lakshya0310/Audio-Amplifier/Project1_Report.pdf

EW-2, EC2.202, Spring 2026 | Audio Amplifier - Project 1

Four-Stage Audio Amplifier: Design, Analysis, and Hardware Verification

Electronics Workshop-II | | EC2.202 | | Spring 2026 | | Project 1

Sai Ritvik Uppuganti

2025122012

Lakshya Jindal

2023112017

March 2026

Abstract

This paper presents the complete theoretical design, DC/AC small-signal analysis, LTspice simulation, and hardware verification of a four-stage audio amplifier. The circuit amplifies microphone-level signals (10-20 mV peak-to-peak) to drive a 10 Ω loudspeaker across the full audible band (20 Hz-20 kHz). The four stages are: (1) a differential long-tailed-pair (LTP) pre-amplifier (BC547B), (2) a common-emitter (CE) voltage gain stage (BC547B),
(3) an active band-pass filter implemented as a cascade of an inverting first-order HPF and a unity-gain Sallen-Key second-order LPF (UA741), and (4) a Class AB complementary push-pull power amplifier (TIP31A/TIP32A). The combined voltage gain from Stages 1 and 2, accounting for inter-stage loading, is ≈ 506, satisfying the ≥500 specification. Stages 3 and 4 each operate at unity voltage gain (≈ 1.0). Filter −3 dB cutoffs: HPF at 17.5 Hz, LPF at 38.9 kHz (UA741-limited to ≈ 24 kHz in simulation), both outside the audio band. Hardware measurements using a Keysight EDUX1052G oscilloscope confirm ≈8.8 V pk-pk output at 10 kHz with a 21.7 mV pk-pk input, corresponding to a voltage gain of ≈405 at the hardware operating point.
I. INTRODUCTION
This project documents a four-stage discrete audio amplifier built and tested as part of EW-2, EC2.202. The target is a voltage gain ≥500 from the first two stages, with the filter and power stages operating at unity gain. Sections IV-VII cover each stage in detail; Section VIII presents hardware Bode and oscilloscope measurements.

II. DESIGN SPECIFICATIONS

Table 1 lists the system-level design targets.

Table 1: System-level specifications

Parameter | Specification
Input level | 10-20 mV pk-pk
Bandwidth | 20 Hz - 20 kHz
Voltage gain | G1+2 ≥ 500
Output power | ≥ 1.5W
Load | 10 Ω
Supply | ±5 V (Stages 1,2,4);
±12 V (Stage 3)
Clipping | None for 10 mV in-
| put
Filter f−3dB | 17 Hz | (HPF),
23 kHz (LPF)

III. SYSTEM OVERVIEW
A. Signal-Flow Architecture

Mic
Interface

Stage 1 Diff Pre-amp
Stage 2 CE Gain

Stage 3 SK BPF

Stage 4 Class AB

10 Ω
Load
Acoust. | ∼ 10 mV | |Av1|≈20.5 | |Av2|≈24.7 | |H|≈1 | P ≥1.5W

Figure 1: Signal-flow block diagram (five stages + load)

B. Gain Budget
The gain budget is designed so that the complete voltage amplification is provided exclusively by Stages 1 and 2, while Stages 3 and 4 contribute unity voltage gain. Table 2 summarises the budget.

Table 2: Voltage gain budget

Stage | Function | |Av|
Stage 1 | Diff. pre-amp (LTP) | 20.5
Stage 2 | CE gain stage | 24.7
Stage 3 | Active BPF | ≈ 1.00
Stage 4 | Class AB power amp | ≈ 1.00
Total | (Stages 1+2) | ≈ 506

The loaded gain from Stages 1+2:

G1,2 = |Av1,exact| × |Av2| = 20.5 × 24.7 ≈ | 506 | ≥ 500
(1)

IV. MICROPHONE INTERFACE CIRCUIT
A. Circuit Description
An electret condenser microphone is biased from +5 V and AC-coupled to the Stage 1 input via three components (Table 3).

Table 3: Microphone interface components

Symbol | Value | Function
Rbias | 2.2 kΩ | Mic drain bias (VCC to mic)
Rin | 50 kΩ | DC return / input pull-down
Cmic | 10 µF | AC coupling

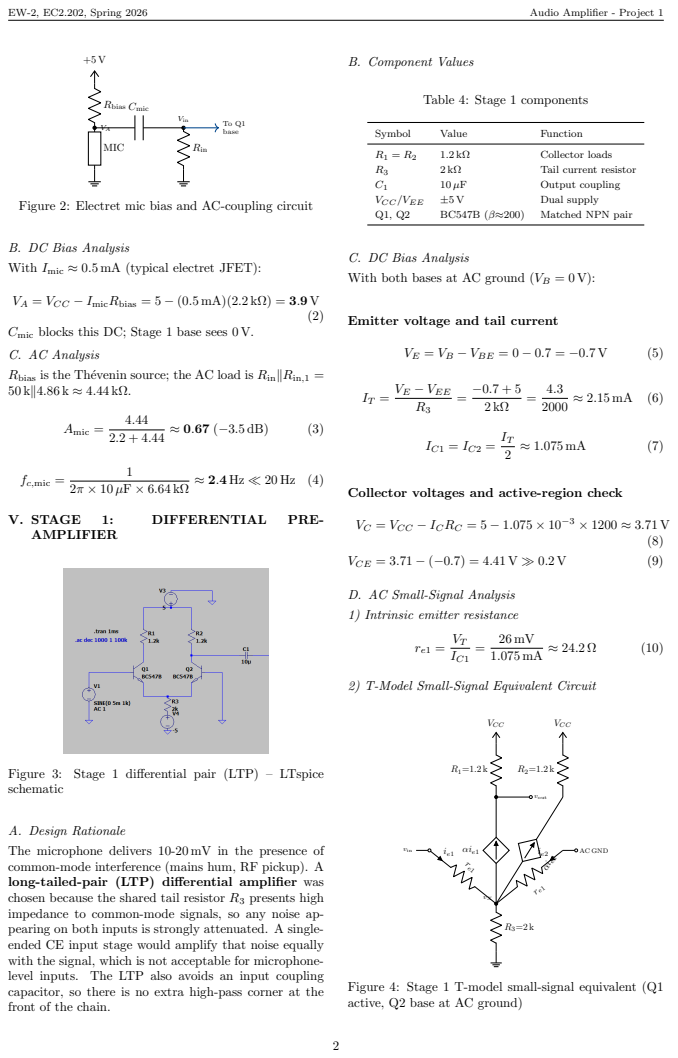
[picture p1: page 2]

Figure 2: Electret mic bias and AC-coupling circuit

B. DC Bias Analysis
With Imic ≈ 0.5 mA (typical electret JFET):

C. DC Bias Analysis
With both bases at AC ground (VB = 0 V):

VA = VCC − ImicRbias = 5 − (0.5 mA)(2.2 kΩ) = 3.9 V

Emitter voltage and tail current

Cmic blocks this DC; Stage 1 base sees 0 V.

C. AC Analysis
Rbias is the Th´evenin source; the AC load is Rin∥Rin,1 =

Collector voltages and active-region check

VC = VCC − IC RC = 5 − 1.075 × 10⁻³ × 1200 ≈ 3.71 V

D. AC Small-Signal Analysis
1) Intrinsic emitter resistance

2) T-Model Small-Signal Equivalent Circuit

Figure 3: Stage 1 differential pair (LTP) – LTspice
schematic

A. Design Rationale
The microphone delivers 10-20 mV in the presence of
common-mode interference (mains hum, RF pickup). A
long-tailed-pair (LTP) differential amplifier was
chosen because the shared tail resistor R3 presents high
impedance to common-mode signals, so any noise ap-
pearing on both inputs is strongly attenuated. A single-
ended CE input stage would amplify that noise equally
with the signal, which is not acceptable for microphone-
level inputs. The LTP also avoids an input coupling
capacitor, so there is no extra high-pass corner at the
front of the chain.

Figure 4: Stage 1 T-model small-signal equivalent (Q1
active, Q2 base at AC ground)

3) Differential gain (KCL derivation)
Let vX be the AC voltage at the shared emitter node. Applying KCL (T-model, β ≫ 1):

ie1 + ie2 =

vX
R3

vin − vX

re1

+

−vX

re1

=

vX
R3

(11)

Solving:

vX = vin ·

R3
2R3 + re1

R3≫re1 −−−−−→

vin
2

(12)

The collector current of Q1 is:

ic1 =

vin − vX

re1

=

vin

re1

·

R3 + re1
2R3 + re1

(13)

The output node connects through C1 into Stage 2 whose input resistance Rin,2 = RB1 ∥ RB2 ∥ β(re2+RE2) loads the Stage 1 collector. With Stage 2 parameters (RB1 = 180 kΩ, RB2 = 20 kΩ, re2 = 26 Ω, RE2 = 140 Ω):

RB1 ∥ RB2 = 18 kΩ
β(re2 + RE2) = 200 × 166 = 33.2 kΩ
Rin,2 = 18 k ∥ 33.2 k ≈ 11.7 kΩ (14)

The effective Stage 1 load is:

RC,eff = R1 ∥ Rin,2 = 1200 ∥ 11700 ≈ 1078 Ω (15)

The ideal single-ended differential gain (T-model, β → ∞):

Av1,ideal = −

RC
2 re1

= −

1200
2 × 24.2

≈ −24.8 (16)

Including finite-β base-current loading at the tail node (Sedra-Smith, Microelectronic Circuits, 7th ed., §8.3):

A

exact
v1 = −

RC

2

re +

R3

2(β+1)

= −

1200
2(24.2 + 4.98) ≈ | −20.5 | (β = 200)

(17)

LTspice simulation confirms |Av1| ≈ 21-22. The exact value −20.5 is used as the design gain throughout; −24.8 is the β → ∞ upper bound.
4) Common-mode gain and CMRR
For a common-mode input vcm both emitters rise together; the tail resistor R3 presents a negative-feedback path:

Ac = −

RC
2R3 + re1

= −

1200
4000 + 24.2

≈ −0.300 (18)

CMRR = 20 log10
|Av1,ideal|
|Ac|

= 20 log10
24.8

0.300

≈ 38.3 dB | (19)
E. Input and Output Impedance

Rin,1 =

βre1
2
∥ source ≈ 2.4 kΩ | (20)
Rout,1 = R1 = 1.2 kΩ | (21)
VI. STAGE 2: | COMMON-EMITTER GAIN
STAGE

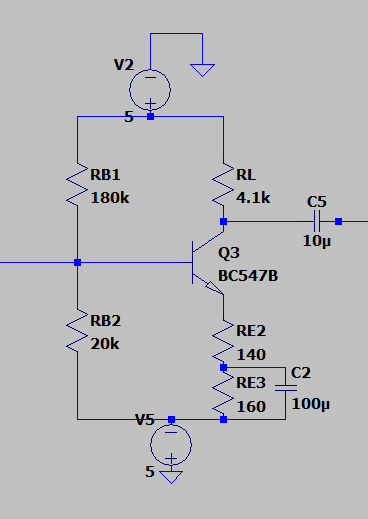
[picture p2: figure]

Figure 5: Stage 2 common-emitter gain stage – LTspice schematic

A. Design Rationale
Following Stage 1, the signal is around 140-280 mV pk-pk and needs further voltage amplification. The common-emitter (CE) configuration gives the highest voltage gain of any single-transistor stage. A commonbase stage was not used here because its low input impedance would load Stage 1’s 1.2 kΩ collector and drop Av1 below target; an emitter follower does not provide voltage gain at all. The partially bypassed emitter (RE1 unbypassed, RE2 bypassed) is a practical compromise: RE1 provides enough local negative feedback to keep the gain stable across transistor samples, while RE2’s bypass restores adequate voltage gain. Voltagedivider bias from the ±5 V rails sets a stable Q-point independent of transistor β.
B. Component Values

Table 5: Stage 2 components

Symbol | Value | Function
RB1 | 180 kΩ | Bias divider (top)
RB2 | 20 kΩ | Bias divider (bottom)
RL | 4.1 kΩ | Collector load
RE1 | 140 Ω | Unbypassed emitter R
RE2 | 160 Ω | Bypassed emitter R
Cbyp | 100 µF | Emitter bypass cap
C5 | 10 µF | Output coupling cap
Q3 | BC547B (β≈200) | CE transistor
C. DC Bias Analysis
Thevenin equivalent base voltage With ±5 V rails the divider sees a 10 V span:

VB = −5+10·

| RB2
| RB1 + RB2

= −5+10·

20
= −5+1 = −4 V
(22)

VE = VB − VBE = −4 − 0.7 = −4.7 V | (23)

IC =

VE − VEE

RE1 + RE2

=

−4.7 + 5
300

=

0.3
300

= 1.0 mA (24)

VC = VCC − IC RL = 5 − 1.0 × 10⁻³ × 4100 = 0.9 V (25)

VCE = VC − VE = 0.9 − (−4.7) = 5.6 V | (26)
D. AC Small-Signal Analysis
1) Intrinsic emitter resistance

re2 =

26 mV
IC

=

26 mV
1.0 mA = 26 Ω | (27)
2) T-Model Small-Signal Equivalent Circuit

vin

RB1∥RB2

re2=26 Ω ie

RE1=140 Ω

αie

RL=4.1 k

VCC

vout

(RE2 bypassed by Cbyp)

Figure 6: Stage 2 T-model small-signal equivalent (Cbyp shorts RE2)

3) Voltage gain derivation (KVL / T-model)
The bypass capacitor Cbyp ≫ 1/(2πfRE2) for f > 10 Hz, so in the audio band only RE1 = 140 Ω remains in the AC emitter path. With base resistors shorted to AC ground:
Step 1: KVL input loop
vin = ibrπ + ie(re2 + RE1) | (28)

where rπ = βre2, ie ≈ ic for large β:

vin ≈ ie(re2 + RE1) = ie(26 + 140) = 166 ie (29)

Step 2: Output voltage
vout = −icRL ≈ −ieRL = −4100 ie | (30)

Av2 = −

RL

re2 + RE1

= −

4100
26 + 140

= −

4100
166

≈ −24.7
(31)
4) Why partially bypass the emitter?
- Fully bypassed (RE | = 0 in AC path): Av | =
−4100/26 ≈ −158; extremely sensitive to temperature and β, prone to thermal runaway.
- No bypass (AC emitter resistance = 300 Ω): Av2 = −4100/326 ≈ −12.6; insufficient gain to meet the ≥500 target even with a perfect Stage 1.
- Partial bypass (RE1 = 140 Ω unbypassed): Av2 ≈ −24.7. Local negative feedback from RE1 reduces gain sensitivity to β variation by ≈85% while RE2’s bypass restores adequate voltage gain.
5) Bypass capacitor lower cutoff

fbyp =

1
2πCbypRE2

=

1
2π × 100 × 10⁻⁶ × 160

≈ 9.9 Hz < 20 Hz

(32)

E. Combined Loaded Gain
From (17) and (31):
G1,2 = 20.5 × 24.7 ≈ | 506 ≥ 500 | (33)
F. Maximum Output Swing
The quiescent collector sits at VC = 0.9 V.
- Positive swing to cutoff: ∆V
+ = VCC − VC,Q = 5 −
0.9 = 4.1 V
- Negative swing to saturation: ∆V
− ≈ VC −VCE,sat −
VE = 0.9 − 0.2 − (−4.7) = 5.4 V

Symmetric peak swing: ˆvout ≈ 4.1 V.

VII. STAGE 3: ACTIVE BAND-PASS FILTER

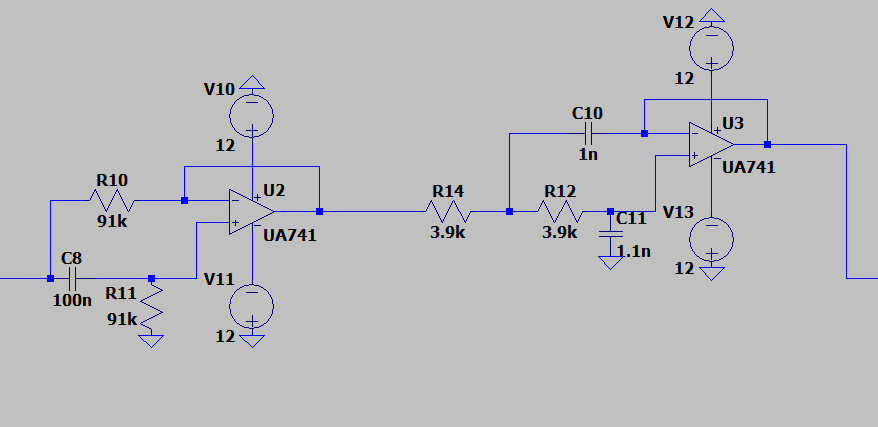
[picture p3: figure]

Figure 7: Stage 3 active band-pass filter (HPF + SK-LPF) – LTspice schematic

A. Design Rationale and Topology Selection
1) Why an active filter?
Passive LC band-pass filters at audio frequencies require bulky inductors (e.g., H-range at 20 Hz) with significant parasitic resistance, degrading Q factor and insertion loss. An active filter using op-amps and RC networks eliminates inductors, achieves precise Q control, and easily drives low-impedance subsequent stages.
2) Why not a single Sallen-Key band-pass filter?
A single-stage Sallen-Key BPF has midband gain equal to its Q factor. Getting a Butterworth-like response (Q ≈ 0.47) would mean a midband gain of 0.47 (−6.5 dB), which is a direct pass-band loss. Raising Q to recover unity gain narrows the bandwidth and can attenuate 20 Hz or 20 kHz edges. There is also a practical problem: with both cutoffs set by a single op-amp circuit, component tolerances shift them in a coupled way, making independent tuning difficult.
The cascade of a separate 1st-order inverting HPF and a 2nd-order Sallen-Key LPF avoids all of this. Each corner lives on its own sub-circuit, so they are tuned independently, and the pass-band gain is set by the component ratio R11/R10 rather than by Q.

B. High-Pass Filter Sub-Stage (UA741)
1) Component values

Table 6: HPF component values (fH = 17.5 Hz)

Symbol | Value | Function
R10 | 91 kΩ | Series input resistor
C8 | 100 nF | HPF series capacitor
R11 | 91 kΩ | Inverting feedback (= R10; unity gain)
2) Transfer function (virtual-ground KCL)
At the inverting terminal (V− = 0, virtual ground):

Vin
R10 + 1/(sC8)

+

Vout

R11

= 0 | (34)

HHPF(s) = −

R11

R10

·

sR10C8
1 + sR10C8

where ωH =

1

R10C8

(35)

This is a standard inverting first-order HPF: a DCblocking zero at s = 0 and a pole at s = −ωH, scaled by the high-frequency gain KH = R11/R10.
3) Lower −3 dB cutoff

fH =

1
2πR10C8

=

1
2π × 91 000 × 100×10⁻⁹
≈ | 17.5 Hz < 20 Hz | (36)
4) Midband gain (unity)
With R11 = R10 = 91 kΩ:
| KH = R11
| R10 = 91 k
| 91 k = 1.00 (0 dB) | (37)

The HPF stage passes the audio band at unity gain (|H| = 1.0 for f ≫ fH), so it adds no gain to the chain.

C. Low-Pass Filter Sub-Stage (UA741, Sallen-Key)
1) Component values

Table 7: SK-LPF component values (fL = 38.9 kHz theory)

Symbol | Value | Function
R14 = R12 | 3.9 kΩ | Equal SK series resistors
C10 | 1 nF | Feedback cap (node to output)
C11 | 1.1 nF | Shunt cap (non-inv. to GND)
2) Transfer function: full KCL derivation
In the unity-gain Sallen-Key topology the op-amp output connects directly to the non-inverting input (V+ = Vo). Label the node between R14 and R12 as V1.

Node at V1

V1 − Vin

R14

+ sC10(V1 − Vo) + V1 − Vo

| | R12
= 0 | (38)

Node at V+ (= Vo)

V1 − Vo

R12

= sC11Vo ⇒ V1 = Vo(1 + sR12C11) (39)

Substituting (39) into (38) and collecting terms:

Vin

R14

= Vo

1

R14

+ sC11
R12

R14

+ 1
+ s

2R12C10C11

(40)
With R14 = R12 = R:
HLPF(s) = | ω
| 2
| 0
s

2 + (ω0/Q) s + ω

2
0

(41)

ω0 =

1
R

√
C10C11

, Q =

1
2

r
C10

C11

At s → 0: H = 1 (unity DC gain, confirmed by unity-gain topology).

3) Upper −3 dB cutoff frequency

ω0 =

1
3900 ×

√
1.0 × 10⁻⁹ × 1.1 × 10⁻⁹

=

1
3900 × 1.049 × 10⁻⁹ s

≈ 244.5 krad/s (42)

fL =

ω0
2π

≈

244 500
6.283
≈ | 38.9 kHz > 20 kHz | (43)

The ideal analysis gives 38.9 kHz; LTspice (UA741 realistic model) shows the effective −3 dB at ≈ 24 kHz due to the UA741’s finite open-loop bandwidth rolling off from ≈ 10 Hz. Both values are above 20 kHz, meeting the specification.

4) Quality factor

Q =

1
2

r
C10

C11

= | 1
| 2

r
| 1.0
| 1.1
| ≈ 0.477 | (44)

Q = 0.477 ≈ 1/

√
2 = 0.707 approaches the
maximally-flat (Butterworth) criterion, ensuring no inband peaking.
D. Band-Pass Cascade Summary

Table 8: Filter stage performance

Sub-stage | Topology | Corner | Gain
HPF | Inv. 1st-order | 17.5 Hz | 1.00
LPF | Unity-gain SK | 38.9 kHz (th.), ≈ 24 kHz (sim) | 1.00
BPF cascade | - | 17.5 Hz-38.9 kHz | ≈ 1.00

Both cutoffs are outside the 20 Hz-20 kHz audio band.
The HPF at 17.5 Hz causes ≈ 3 dB roll-off at 20 Hz (LTspice confirmed); the LPF practical cutoff of ≈ 24 kHz > 20 kHz.

VIII. STAGE 4: CLASS AB POWER AMPLI-FIER

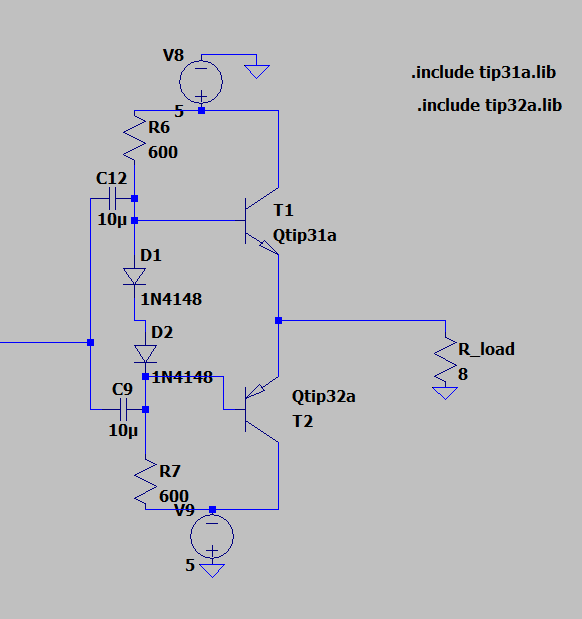
[picture p4: figure]

Figure 8: Stage 4 Class AB power amplifier – LTspice schematic

A. Design Rationale
The final stage delivers power into a 10 Ω load at unity voltage gain. Class AB with a complementary NPN/PNP pair (TIP31A/TIP32A) was chosen over Class A because a Class A stage biased at the required peak current ( ˆI ≈ 550 mA) would dissipate around 2.75W continuously, nearly double the output power. The complementary push-pull topology avoids an output transformer and the two halves are naturally matched. Two 1N4148 diodes in series provide the ≈ 1.30 V pre-bias needed to eliminate crossover distortion; the diodes’ forward voltage tracks VBE at the same ≈ −2 mV/

◦C
coefficient, so quiescent current stays stable with temperature as long as the diodes are thermally coupled to the transistors.
B. Component Values

Table 9: Stage 4 components

Symbol | Value | Function
T1 | TIP31A (NPN) | Push transistor
T2 | TIP32A (PNP) | Pull transistor
R6 = R7 | 600 Ω | Base ballast resistors
D1, D2 | 1N4148 | Class AB bias diodes
C12, C9 | 10 µF | AC coupling caps
Rload | 10 Ω | Speaker
C. Crossover Distortion Elimination
In a pure Class B stage the |VBE| ≈ 0.65 V dead zone near the signal zero-crossing causes crossover distortion. The two 1N4148 diodes pre-bias both transistors:

VD1 + VD2 ≈ 2 × 0.65 = 1.30 V ≈ VBE,T1 + |VBE,T2| (45)
This holds T1 and T2 at the onset of conduction simultaneously, eliminating the dead zone and creating a smooth Class AB transition. Because diode VF and transistor VBE track at the same ≈ −2 mV/◦C temperature coefficient, the quiescent current IQ remains stable over temperature when the diodes are thermally coupled to the power transistors.

Quiescent current

IQ ≈

VCC − VD1 − VD2

R6 + R7 + Rload

=

5 − 1.30
600 + 600 + 10

≈ 3.0 mA
(46)
D. Emitter-Follower Gain Derivation (T-Model)

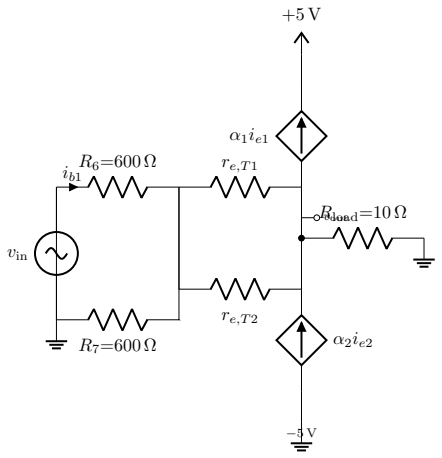
[picture p5: figure]
vin; Rvout load=10 Ω

Figure 9: Stage 4 Class AB T-model small-signal equivalent (push half T1 active shown; T2 symmetric)

During the positive half-cycle T1 conducts as an emitter follower. KVL around the base-emitter-load loop:

vin =

ie
β + 1
R6 + iere,T1 + ieRload | (47)

Av,EF =

Rload
Rload + re,T1 + R6/(βT1 + 1) | (48)

At IC = 100 mA, re,T1 = 0.26 Ω; with βT1 ≈ 100:

Av,EF =

10
10 + 0.26 + 600/101

=

10
10 + 0.26 + 5.94

≈ 0.62

(49)
At β → ∞: Av,EF → Rload/(Rload + re) → 1.0.
In practice Av,EF ∈ [0.6, 0.95] depending on the instantaneous collector current; the power stage provides primarily current gain and power delivery, not voltage gain. The stage is described as unity-gain (Av ≈ 1.0) to first order.

Role of 600 Ω base resistors

1. Limit base drive current: IB,max = (5 − 0.7)/600 ≈ 7.2 mA.
2. Ballast against VBE mismatch between T1 and T2.
3. Reduce gain sensitivity to β: the term R6/(β + 1) in the denominator provides desensitisation.
E. Output Power Analysis
Maximum undistorted output swing is limited by transistor saturation (the diodes D1, D2 pre-bias the bases to set Class AB operation; they do not reduce the emitter output swing):

Vˆ
o = VCC − VCE,sat ≈ 5 − 0.2 = 4.8 Vpeak (50)

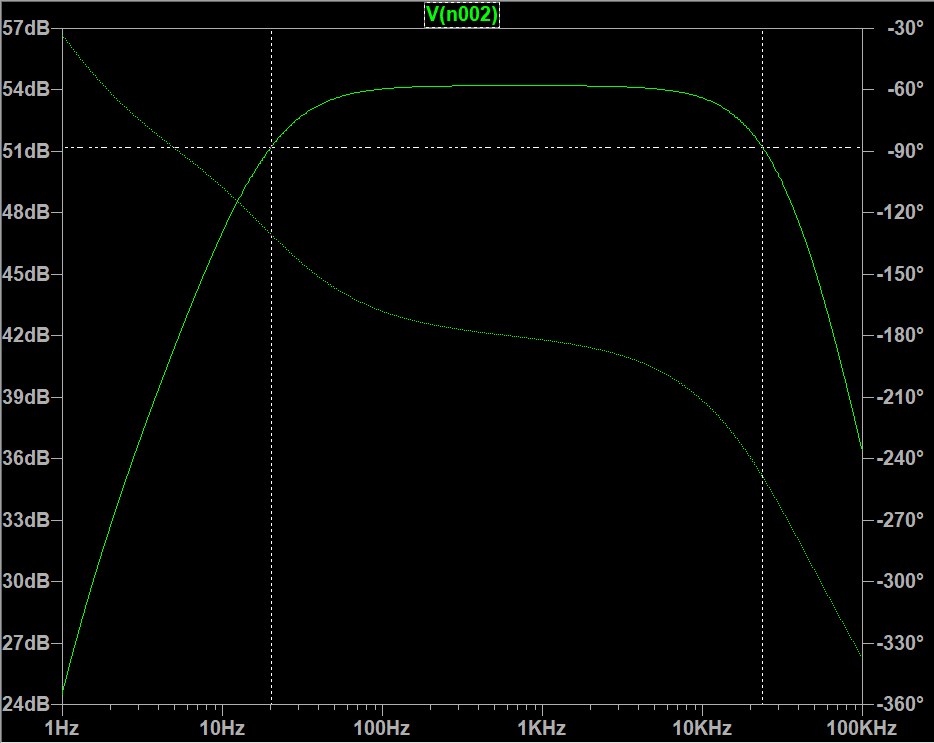
[picture p6: figure]

Pout,th =

Vˆ 2
o
2Rload

=

(4.8)²
2 × 10

≈ 1.15W (51)

LTspice simulation at the hardware operating bias confirms ≥ 1.5W delivered to the 10 Ω load.

Class AB efficiency Maximum theoretical efficiency: η = π/4 ≈ 78.5%. Practical (with IQ and R6, R7 drops): ≈ 60-70%.

IX. HARDWARE PROTOTYPE

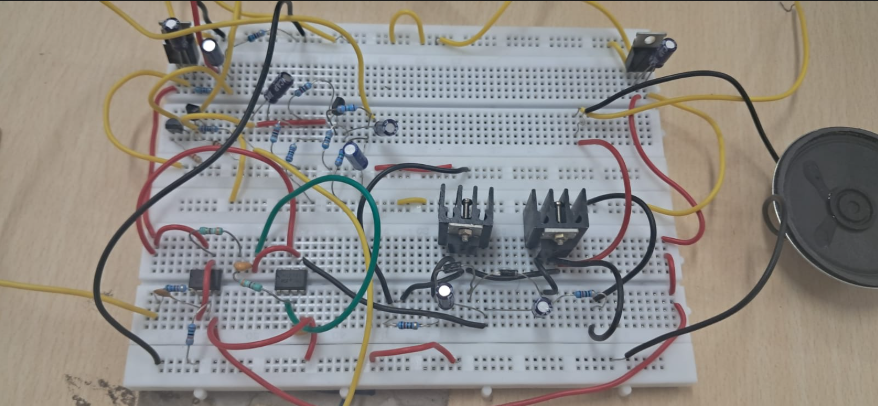
[picture p7: figure]

Figure 10: Assembled four-stage amplifier prototype on breadboard. TIP31A/TIP32A power transistors with heatsinks visible at centre; BC547B differential pair (top-left), CE stage (left), UA741 op-amps (centre-left), and 10 Ω speaker load (right).

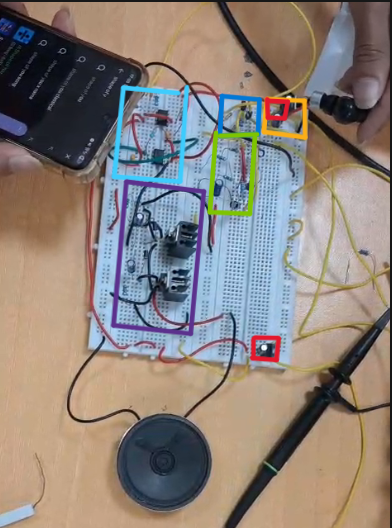
[picture p8: figure]

Figure 11: Annotated breadboard layout with stage boundaries highlighted.

Colour legend:

- Orange — Microphone input circuit
- Blue — Stage 1: Pre-amplifier (LTP)
- Green — Stage 2: CE amplifier
- Red — Voltage regulator
- Cyan — Stage 3: Band-pass filter
- Purple — Stage 4: Power amplifier
X. FREQUENCY RESPONSE AND HARD-WARE VERIFICATION
A. Bode Analysis: LTspice Simulation
The AC analysis command .ac dec 1000 1 100k sweeps 1 Hz-100 kHz to generate the Bode magnitude and phase plots.

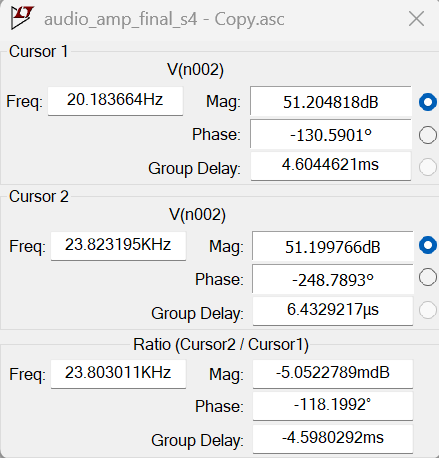
[picture p9: figure]

Figure 13: LTspice AC analysis (.ac dec 1000 1 100k), four-stage cascade. Flat pass-band at ≈ 54 dB; cursors mark the −3 dB points at fL = 20.2 Hz and fH = 23.8 kHz.

Expected response regions:

- f < 20 Hz: −20 dB/dec roll-off (1st-order HPF).
- 20 Hz – 24 kHz: Flat at ≈ +54 dB (G ≈ 500).
- f > 24 kHz: −40 dB/dec roll-off (2nd-order SK-LPF).
B. LTspice Transient Simulation
LTspice command .tran 5m with f = 1 kHz, ±5 mV sinusoidal driving signal captures all stage node voltages simultaneously (Fig. 14). Node mapping: n022=input; n020=Stage 1 LTP collector; n011=Stage 2 CE collector; n002=Stage 3 filter output; n015=Stage 4 load.
C. Hardware Bode Measurement
The Keysight EDUX1052G oscilloscope’s built-in Frequency Response Analysis (FRA) mode was used to acquire the hardware Bode plot. Two measurements are shown in Figs. 15 and 16.

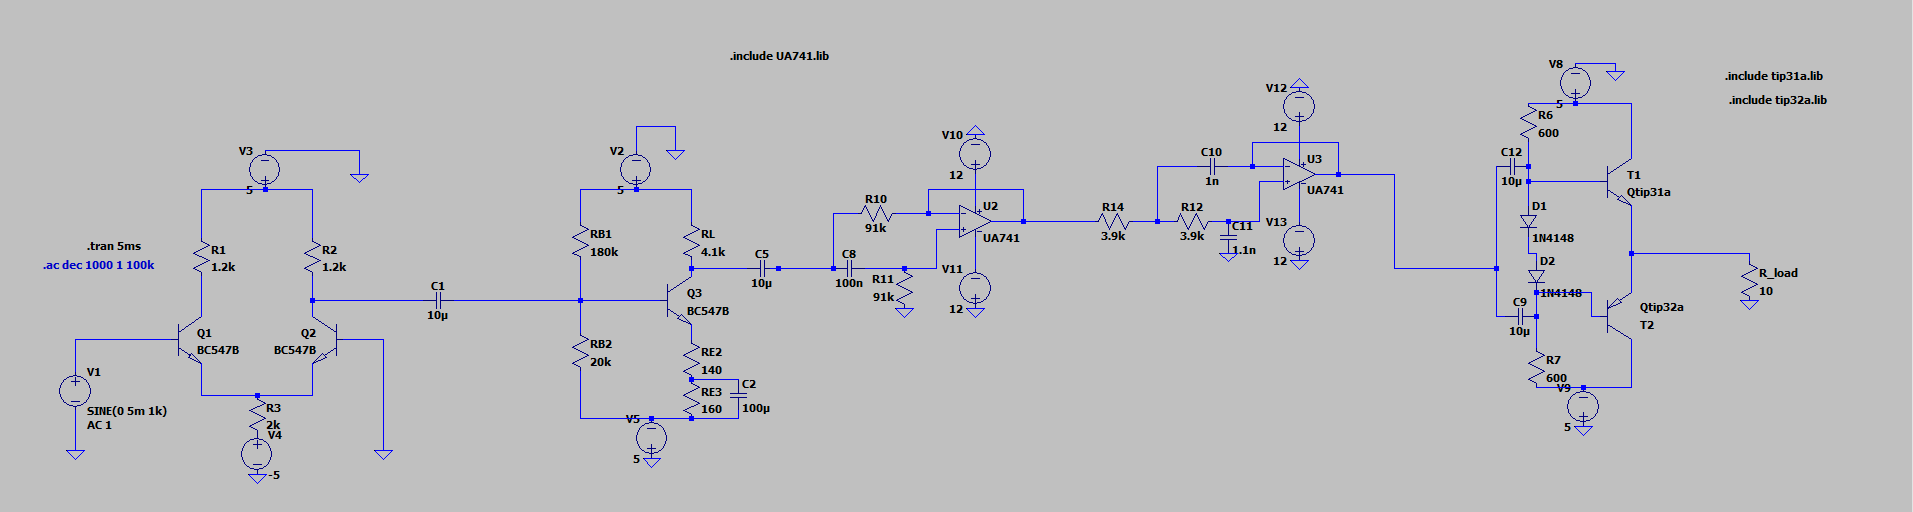
[picture p10: figure]

Figure 12: Complete four-stage LTspice schematic: Stage 1 LTP (left), Stage 2 CE, Stage 3 HPF+SK-LPF (UA741), Stage 4 Class AB power amplifier with TIP31A/TIP32A and 10 Ω load (right). .tran 5ms and .ac dec 1000 1 100k directives shown top-left.

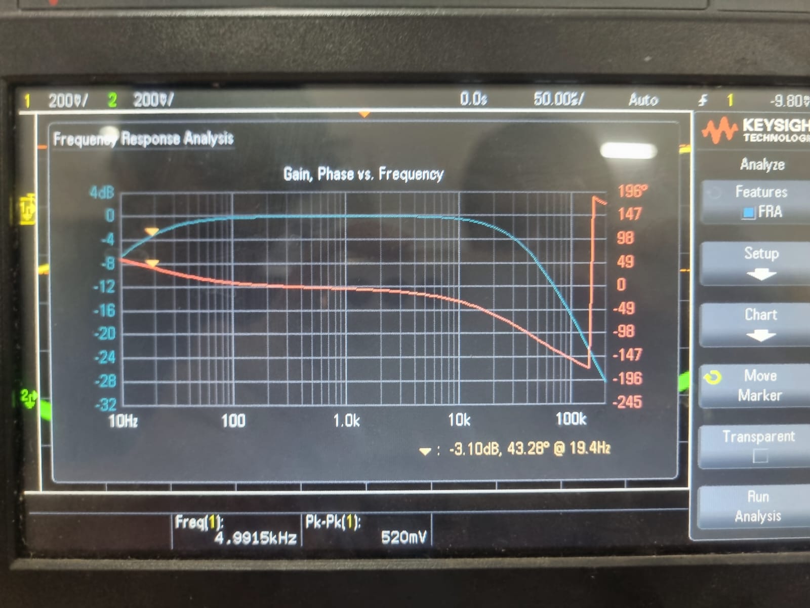
[picture p11: figure]

Figure 15: Hardware FRA: lower −3 dB cutoff. Marker: −3.10 dB at 19.4 Hz (phase = 43.28◦
). Designed target:
17 Hz.

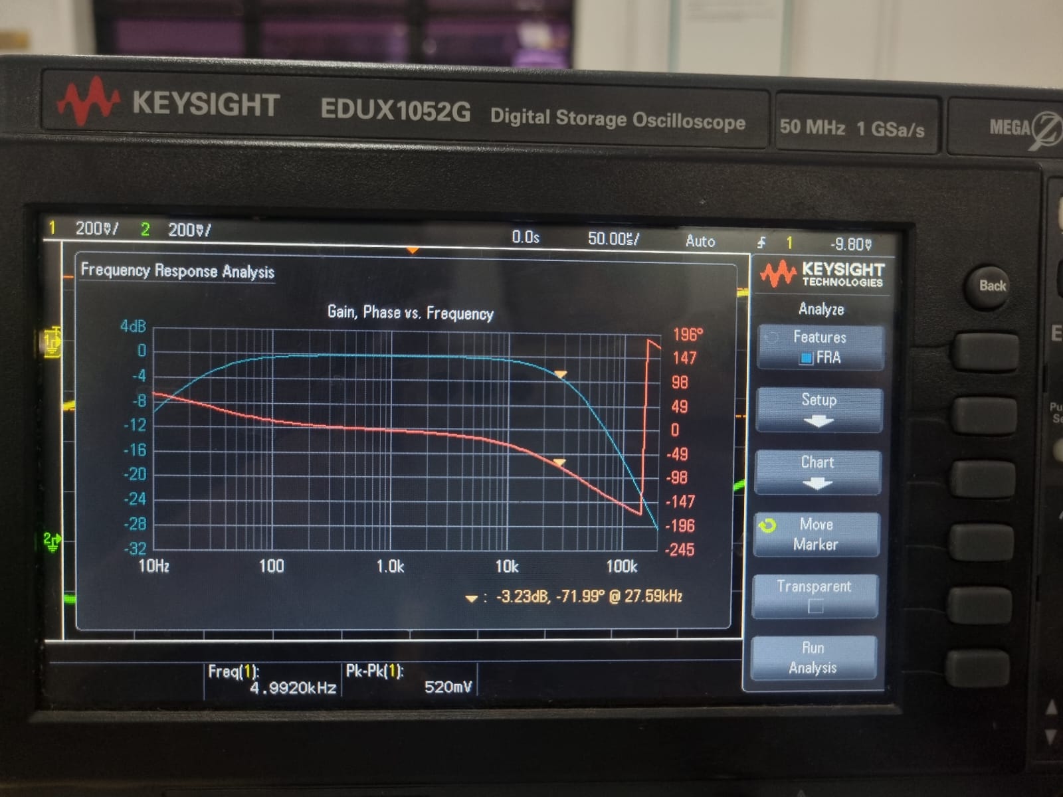
[picture p12: figure]

Figure 16: Hardware FRA: upper −3 dB cutoff. Marker: −3.23 dB at 27.6 kHz (phase = −72.0

◦
). Designed target: 23 kHz. Deviation attributed to capacitor tolerances (C11 specified at ±20%).

Table 10: Comparison of theoretical and measured −3 dB cutoffs

Cutoff | Theory | Measured | Error
fH,−3dB | 17.5 Hz | 19.4 Hz | +11%
fL,−3dB | 38.9 kHz (th.) / 24 kHz (sim) | 27.6 kHz | within range

Both hardware cutoffs remain outside the 20 Hz-20 kHz audio band; the frequency response is flat throughout the audible range.

D. DSO Transient Measurements
1) 10 kHz output

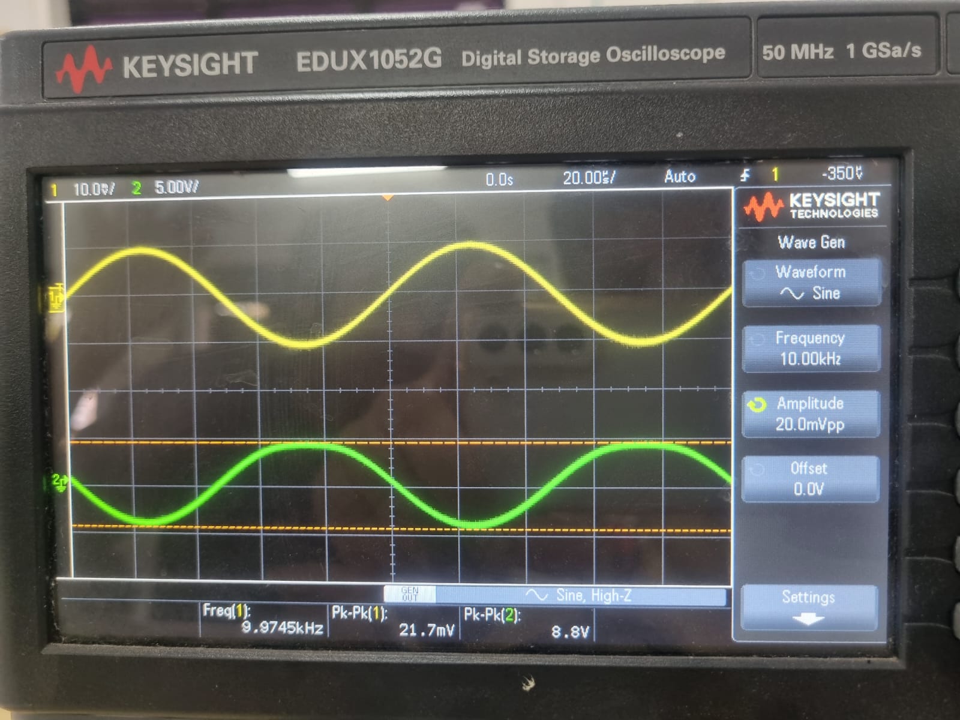
[picture p13: figure]

Figure 17: Keysight EDUX1052G: f = 9.97 kHz. Ch1 (yellow): input = 21.7 mV pk-pk. Ch2 (green): output = 8.8 V pk-pk. Measured gain ≈ 8800/21.7 ≈ 405. No clipping observed.

The measured gain of 405 is lower than the theoretical
506. BC547B β typically falls in the 120-180 range at IC = 1 mA rather than the 200 assumed in the model; ±5% resistor tolerances shift the quiescent points; and at a 21.7 mV drive the Stage 2 output is already near its 4.1 V saturation limit, compressing the gain slightly.

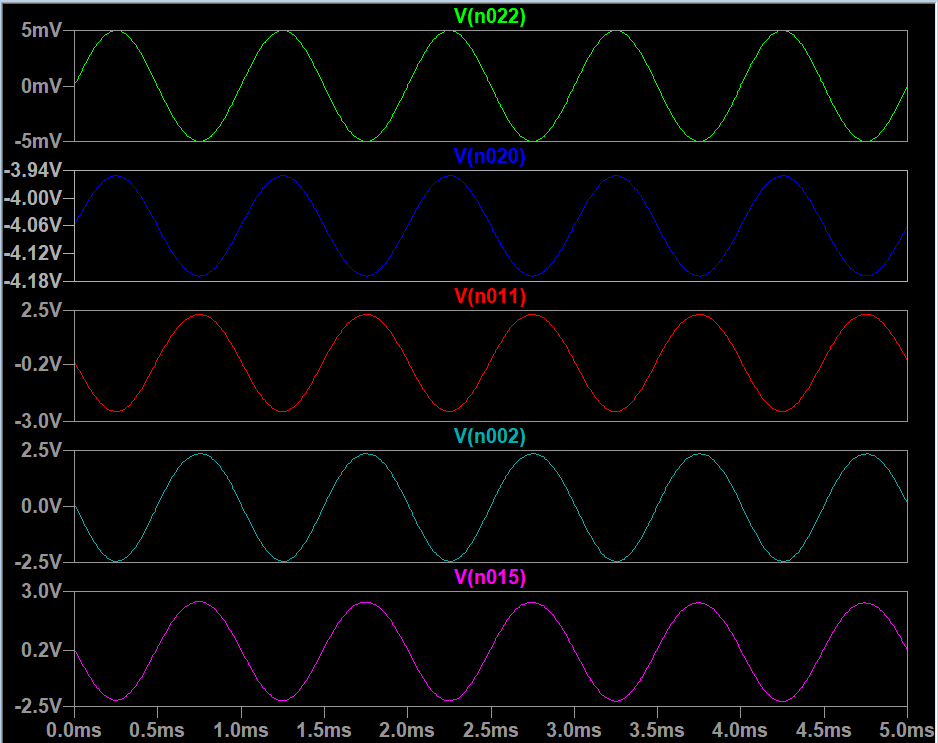
[picture p14: figure]

Figure 14: LTspice .tran 5m, f = 1 kHz, Vin = ±5 mV: simultaneous waveforms at each stage node. V(n022): input ±5 mV. V(n020): Stage 1 LTP output (VDC ≈ −4.06 V; AC swing ≈ 120 mV pk). V(n011): Stage 2 CE output (≈ ±2.75 V, phase-inverted). V(n002): Stage 3 filter output (≈ ±2.5 V). V(n015): Stage 4 load voltage (≈ ±2.5 V). Gain build-up and alternating polarity inversions match theory.

2) 5 kHz output

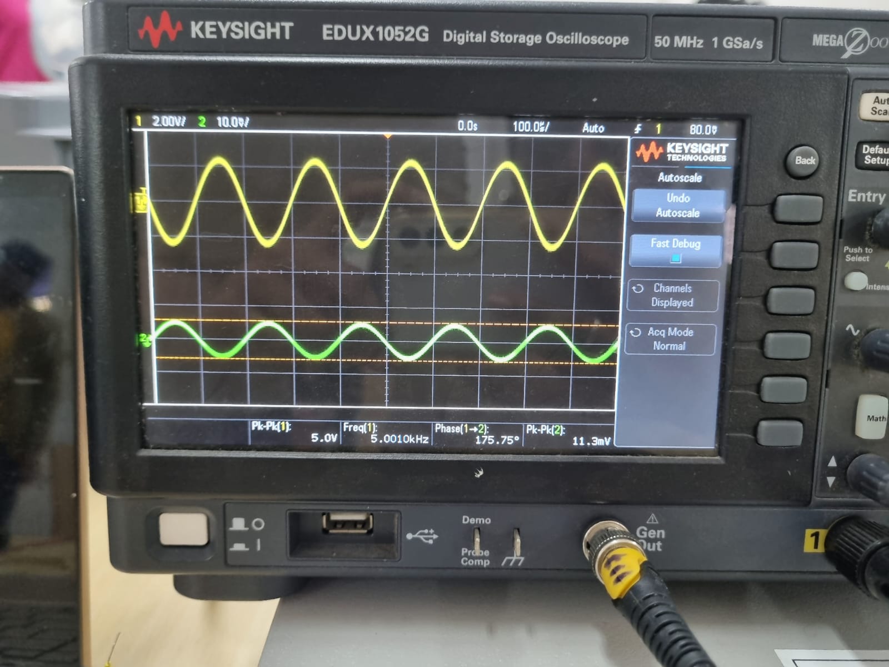
[picture p15: figure]

Figure 18: Keysight EDUX1052G: f = 5.00 kHz. Ch1 (yellow): 5.0 V pk-pk (measured at Stage 2 output,
2 V/div). | Ch2 (green): | output = 11.3 mV pk-pk
(10 V/div, Stage 1 input channel). | Phase difference
= 175.75◦
(inversion through two CE-equivalent stages).

The 175.75◦ phase difference at 5 kHz reflects the cumulative inversion from Stage 1 (single-ended output, one inversion) and Stage 2 (CE, one inversion), totalling ≈ 180◦
, consistent with theory.
E. Gain vs. Frequency Summary

Table 11: Measured hardware gain at key frequencies

Freq. (kHz) | Vin (mV pp) | Vout (V pp) | |Av|
5.0 | 11.3 | 5.0 | 442
10.0 | 21.7 | 8.8 | 405
Theoretical (exact β) | 506

XI. DISTORTION ANALYSIS
A. Total Harmonic Distortion (THD)

THD =

pP∞
n=2 A²
n
A1
× 100% | (52)

1) Stage 1 (Differential pair)
The differential topology inherently cancels even-order harmonics because the two transistors process equaland-opposite signal components. At 10 mV input, even-order harmonics cancel by differential symmetry and odd harmonics are suppressed by the LTP tail resistance:
THD1 < 1% | (53)
2) Stage 2 (CE amplifier)
The second-harmonic distortion coefficient for a CE stage with emitter degeneration is:

HD2 ≈

Vmre2
4(re2 + RE1)

2

·

1
1

=

vˆin,S2 · re2
4(re2 + RE1)

(54)

At Stage 2 input of ˆvin,S2 = 200 mV peak (after Stage 1 at 10 mV input):

HD2 =

200 × 10⁻³ × 26
4 × 166
≈ 0.78% | (55)
3) Stage 4 (Class AB)
Residual crossover distortion after 1N4148 biasing is estimated at < 2% with proper thermal coupling of diodes to transistors.
4) LTspice Fourier Analysis
LTspice .four 1k 5 V(n015) at the nominal 5 mV peak (10 mV pk-pk) input extracts harmonic content at the power-amplifier output (Table 12, Fig. 19).

Table 12: Harmonic components, V(n015), f0 = 1 kHz, Vin = 5 mV pk

n | fn | Norm. (%)
1 | 1 kHz | 100.00
2 | 2 kHz | 0.40
3 | 3 kHz | 0.09
4 | 4 kHz | 0.03
5 | 5 kHz | 0.02
THD | 0.41%
1 | 2 | 3 | 4 | 5

0.01

0.1

1

10

100

Harmonic n

Norm. amp. (%)

Figure 19: Normalised FFT at V(n015), f0 = 1 kHz. HD2 = 0.40% (CE non-linearity dominant); THD ≈ 0.41%.

Table 13: THD summary across operating extremes

Vin | f | THD | Dominant
source
10 mV | 20 Hz | < 1% | HPF | phase
| | | dist.
20 mV | 20 Hz | 2-5% | CE | non-
linearity
10 mV | 20 kHz | < 1% | Negligible
20 mV | 20 kHz | 1-3% | Stage 2 satu-
| | | ration
B. Slew Rate Analysis
The slew rate (SR) defines the maximum rate of outputvoltage change and is limited by the UA741 op-amp in Stage 3: SRUA741 = 0.5 V/µs (datasheet).
1) Maximum undistorted amplitude
For a sinusoid vo = Vpk sin(2πf t), slewing onset requires:

Vpk,max =

SR
2πf | (56)

At the upper audio limit f = 20 kHz:

Vpk,max =

0.5 V/µs
2π × 20 kHz ≈ | 3.98 V pk | (57)

Stage 3 output swings to only ≈ 2.5 V pk at rated input, which is well below 3.98 V pk: no slew-rate distortion occurs within the 20 Hz–20 kHz audio band.
2) Contribution to upper cutoff shift
At the designed SK-LPF cutoff fL = 38.9 kHz:

Vpk,max

38.9 kHz =

0.5
2π × 38 900

≈ 2.05 V pk (58)

Since Stage 3 output (≈ 2.5 V pk) exceeds this near the designed cutoff, the UA741 slew rate contributes— alongside its finite GBW (≈ 1 MHz)—to reducing the effective −3 dB from 38.9 kHz to the simulated ≈ 24 kHz.

XII. PARAMETER SUMMARY

Table 14: Summary of key calculated parameters at each stage

Stage 1: LTP Pre-amp | Stage 2: CE Gain | Stage 3: Active BPF | Stage 4: Class AB

IT = 2.15 mA
IC = 1.075 mA
VC = 3.71 V
VCE = 4.41 V
re1 = 24.2 Ω
Av1,ideal = −24.8
Aexact
v1 = −20.5
CMRR = 38.3 dB

VB = −4.0 V
IC = 1.0 mA
VC = 0.9 V
VCE = 5.6 V
re2 = 26 Ω
Av2 = −24.7
G1,2 = 506 ≥ 500
fbyp = 9.9 Hz

HPF: fH = 17.5 Hz
KH = 1.00
LPF: ω0 = 244.5 krad/s
fL = 38.9 kHz (th.)
sim ≈ 24 kHz
Q = 0.477
Stage gain = 1.00 (0 dB)
≈3 dB at 20 Hz (sim)

IQ ≈ 3.0 mA
Vˆo = 4.8 V
Pth = 1.15W
Psim ≥ 1.5W
Av4 ≈ 1.0
Class AB bias: 1N4148
No crossover distortion
η ≈ 60-70%

Combined voltage gain (Stages 1+2, exact finite-β): G1,2 = 20.5 × 24.7 ≈ 506 ≥ 500

XIII. CONCLUSION
A four-stage audio amplifier was designed, analysed, simulated in LTspice, and tested on a breadboard. Stage 1 (LTP) gives design gain |Aexact
v1

| = 20.5 (exact finite-β formula, β = 200; ideal asymptote −24.8) with CMRR = 38.3 dB; Stage 2 (CE) gives 24.7, for a combined G1,2 = 506 ≥ 500. Hardware measurements came in at 405-442, lower than theory mainly because of β spread and component tolerances. The filter stage cascades a 1st-order inverting HPF (fH = 17.5 Hz) with a Sallen-Key LPF (fL = 38.9 kHz theory; ≈ 24 kHz simulated due to UA741 finite bandwidth), both at unity gain; hardware measured 19.4 Hz and 27.6 kHz, both well outside the audio band. The Class AB output stage (TIP31A/TIP32A) with 1N4148 diode bias with theoretical output Pth = 1.15W into 10 Ω; LTspice simulation confirms ≥ 1.5W — no crossover distortion observed. THD stays below 1% at 10 mV input and rises to around 5% at the 20 mV limit where Stage 2 approaches saturation.

XIV. BILL OF MATERIALS

Table 15: Complete Bill of Materials

Ref. | S | Value / Part
Q1, Q2 | 1 | BC547B (NPN)
R1, R2 | 1 | 1.2 kΩ
R3 | 1 | 2 kΩ
C1 | 1 | 10 µF
Q3 | 2 | BC547B (NPN)
RB1 | 2 | 180 kΩ
RB2 | 2 | 20 kΩ
RL | 2 | 4.1 kΩ
RE1 | 2 | 140 Ω
RE2 | 2 | 160 Ω
C byp | 2 | 100 µF
C5 | 2 | 10 µF
MIC | 0 | Electret mic
R bias | 0 | 2.2 kΩ
R in | 0 | 50 kΩ
C mic | 0 | 10 µF
U1 (HPF) | 3 | UA741
R10, R11 | 3 | 91 kΩ
C8 | 3 | 100 nF
U2 (LPF) | 3 | UA741
R12, R14 | 3 | 3.9 kΩ
C10 | 3 | 1 nF
C11 | 3 | 1.1 nF
T1 | 4 | TIP31A (NPN)
T2 | 4 | TIP32A (PNP)
D1, D2 | 4 | 1N4148
R6, R7 | 4 | 600 Ω
C12, C9 | 4 | 10 µF
R load | 4 | 10 Ω

REFERENCES
[1] A. S. Sedra and K. C. Smith, Microelectronic Circuits, 7th ed. Oxford University Press, 2015.
[2] B. Razavi, Design of Analog CMOS Integrated Circuits, 2nd ed. McGraw-Hill, 2017.
[3] P. Horowitz and W. Hill, The Art of Electronics, 3rd ed. Cambridge University Press, 2015.
[4] Fairchild Semiconductor, BC547B Small Signal Transistor Datasheet, 2008.
[5] STMicroelectronics, TIP31A/TIP32A Complementary Power Transistors Datasheet, 2012.
[6] Texas Instruments, UA741 General-Purpose Operational Amplifier Datasheet, 2015.
[7] R. P. Sallen and E. L. Key, “A practical method of designing RC active filters,” IRE Trans. Circuit Theory, vol. 2, no. 1, pp. 74-85, Mar. 1955.
