lakshya0310/Audio-Amplifier/audio_amp_final_s3.asc

C1: cap; 10µ
C2: cap; 100µ
C5: cap; 10µ
C8: cap; 100n
C9: cap; 10µ
C10: cap; 1n
C11: cap; 1.1n
C12: cap; 10µ
D1: diode; 1N4148
D2: diode; 1N4148
Q1: npn; BC547B
Q2: npn; BC547B
Q3: npn; BC547B
R1: res; 1.2k
R2: res; 1.2k
R3: res; 2k
R6: res; 600
R7: res; 600
R10: res; 56k
R11: res; 91k
R12: res; 3.9k
R14: res; 3.9k
R_load: res; 8
RB1: res; 180k
RB2: res; 20k
RE2: res; 140
RE3: res; 160
RL: res; 4.1k
T1: npn; Qtip31a
T2: pnp; Qtip32a
U2: opamp2; UA741
U3: opamp2; UA741
V1: voltage; SINE(0 5m 10k); AC 1
V2: voltage; 5
V3: voltage; 5
V4: voltage; -5
V5: voltage; 5
V6: voltage; PULSE(-1 1 0 10n 10n 10u 20u)
V7: voltage; SINE(0 10m 1k)
V8: voltage; 5
V9: voltage; 5
V10: voltage; 12
V11: voltage; 12
V12: voltage; 12
V13: voltage; 12
V14: voltage; ""; AC 1
Named nets: 0
.tran 0.5ms
.include UA741.lib
.include tip31a.lib
.include tip32a.lib
.ac dec 1000 1 100k
.tran 0 200u
.tran 0 50m 10m
.four 1k V(n015)
