lakshya0310/Audio-Amplifier/stage1_pre_amp.asc

C1: cap; 10µ
Q1: npn; BC547B
Q2: npn; BC547B
R1: res; 1.2k
R2: res; 1.2k
R3: res; 2k
V1: voltage; SINE(0 10m 3k); AC 1
V2: voltage; 5
V3: voltage; -5
Named nets: 0
.tran 2ms
