lakshya0310/Audio-Amplifier/stage2_ce_amp.asc

C1: cap; 100µ
Q1: npn; BC547B
RB1: res; 180k
RB2: res; 20k
RE1: res; 140
RE2: res; 160
RL1: res; 4.1k
V1: voltage; 5
V2: voltage; 5
V3: voltage; SINE(0 10m 3k); AC 1
Named nets: 0
.tran 2ms
