lakshya0310/Audio-Amplifier/stage3_filter_sallen_key_lpf_hpf.asc

C1: cap; 100n
C2: cap; 1n
C3: cap; 1.1n
R1: res; 56k
R2: res; 91k
R3: res; 3.9k
R4: res; 3.9k
U1: opamp2; UA741
U2: opamp2; UA741
V1: voltage; 12
V2: voltage; 12
V3: voltage; 12
V4: voltage; 12
V5: voltage; SINE(0 10m 3k); AC 1
Named nets: 0
.include UA741.lib
.tran 2ms
.ac dec 1000 1 100k
