lakshya0310/Audio-Amplifier/stage4_power_amp.asc

C1: cap; 1µ
C2: cap; 1µ
D1: diode; 1N4148
D2: diode; 1N4148
R1: res; 600
R2: res; 600
R_load1: res; 10
T1: npn; Qtip31a
T2: pnp; Qtip32a
V1: voltage; 5
V2: voltage; 5
V3: voltage; SINE(0 10m 3k); AC 1
Named nets: 0
.include tip31a.lib
.include tip32a.lib
.tran 2ms
